martinberlin/H-spi-adapters/1.54-watch-pcb/154-watch.kicad_pcb

## KiCad design 1.54-watch-pcb/154-watch.kicad_pcb (2023-06-03)

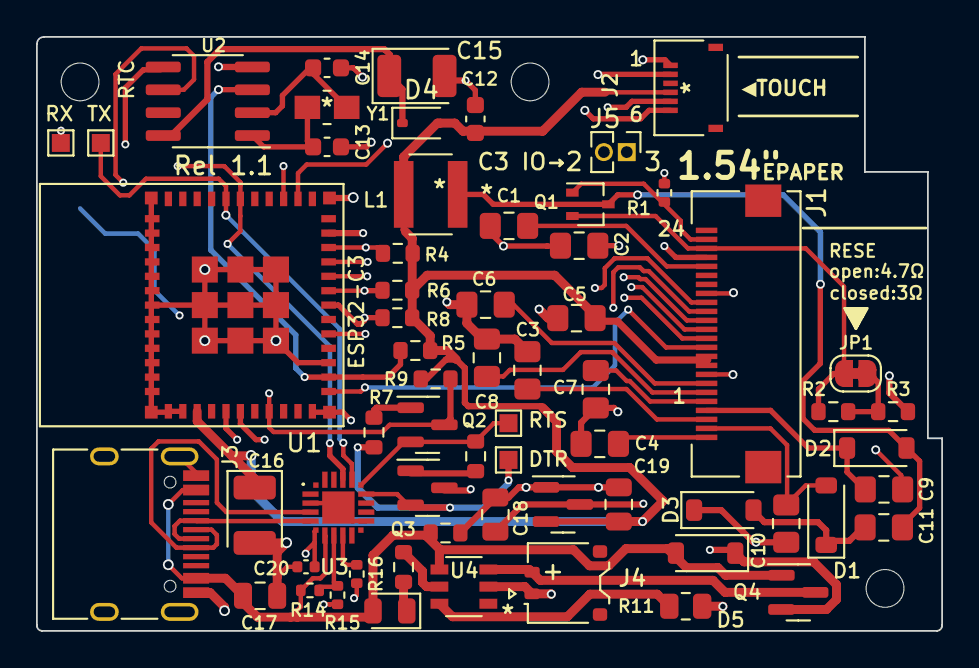
[picture p3: board 154-watch.kicad_pcb from above]

Board: 4 copper layers, 50.3 x 33.0 mm, 67 parts (1 on the bottom side), 51 nets.

Parts:
C1, C2, C3, C7, C9, C10: 4.7uF; C_0805_2012Metric_Pad1.18x1.45mm_HandSolder
C4, C5, C6, C8: 1uF; C_0805_2012Metric_Pad1.18x1.45mm_HandSolder
C11: 4.7uF 50V; C_0805_2012Metric_Pad1.18x1.45mm_HandSolder
C12: 4.7uF; C_0603_1608Metric
C13, C14: 12 pF; C_0603_1608Metric
C15, C16: C_Polarized 100uF; CP_EIA-3528-21_Kemet-B
C17: 100 nF; C_0805_2012Metric
C18, C19: 10uF; C_0805_2012Metric
C20: 1uF; C_0402_1005Metric
D1, D2, D3: MBR0530; D_SOD-123
D4: 1N4148WS; D_SOD-323
D5: 1N5817; D_SOD-123
D6: GRE; LED_0805_2012Metric
H1, H3, H4: MountingHole; MountingHole_2.1mm
J1: AFC24-S24FIC-00
J2: Conn_01x06_Female; FH34SRJ-6S-0.5SH50-Hirose
J3: USB_C_Programming; USB_C_Receptacle_HRO_TYPE-C-31-M-12
J4: Jack-DC; JST_ACH_BM02B-ACHSS-GAN-ETF_1x02-1MP_P1.20mm_Vertical
J5: Conn_01x02_Male; PinHeader_1x02_P1.27mm_Vertical
JP1: Jumper_2_Bridged; SolderJumper-2_P1.3mm_Bridged_RoundedPad1.0x1.5mm
L1: 10uH; SWPA4030S1R0NT
Q1: Si1308; SOT-323_SC-70
Q2, Q3: BC817; SOT-23
Q4: Si2301CDS; SOT-23
R1: 10K; R_0402_1005Metric
R2: 1.7R; R_0603_1608Metric
R3: 3R; R_0603_1608Metric
R4: 4.7 K; R_0603_1608Metric
R5, R7, R9, R10: 10 K; R_0603_1608Metric
R6, R8: 4.7K; R_0603_1608Metric
R11: 2K2; R_0805_2012Metric
R12: 5K; R_0603_1608Metric
R13: 10K; R_0603_1608Metric
R14: 22K; R_0402_1005Metric
R15: 47K; R_0402_1005Metric
R16: 4.7K; R_0402_1005Metric
SW1: RESET; Alps_SKRK
TP1, TP2, TP3, TP4: 32Khz; TestPoint_Pad_1.0x1.0mm
U1: ESP32-C3-MINI-1-N4
U2: PCF8563T; SOIC-8_3.9x4.9mm_P1.27mm
U3: CP2102N-Axx-xQFN20; CP2102NA02GQFN20
U4: TP4057-42-SOT26-R
U5: MCP1700-3302E_SOT23; SOT-23
Y1: Crystal_Small; Q13FC1350000400-Crystal

Connections:
+3V3: C5.2, C12.2, C16.1, C19.1, D4.2 (A), J1.9, J1.10, J2.4, L1.2, R4.1, R5.1, R6.2, R8.2, R9.1, U1.3 (3V3), U5.2 (VO)
/CTS: Q3.2 (E), R7.2, TP2.1, U3.15 (~CTS)
/EPD_BUSY: J1.16, U1.21 (IO7)
/EPD_CLK: J1.12, U1.20 (IO6)
/EPD_CS: J1.13, U1.27 (IO19)
/EPD_DC: J1.14, U1.26 (IO18)
/EPD_MOSI: J1.11, U1.12 (IO0)
/EPD_RST: J1.15, U1.16 (IO10)
/I2C_SCL: J2.5, R8.1, U1.18 (IO4), U2.6 (SCL)
/I2C_SDA: J2.6, R6.1, U1.19 (IO5), U2.5 (SDA)
/IO_2: J5.1, U1.5 (IO2)
/IO_3: J5.2, U1.6 (IO3)
/RTC_INT: R5.2, U1.13 (IO1), U2.3 (~INT)
/RTS: Q2.2 (E), R10.1, TP1.1, U3.16 (~RTS)
/TOUCH_INT: J2.2, R4.2, U1.22 (IO8)
/VCOM: C4.2, J1.1
BOOTMODE: Q3.3 (C), U1.23 (IO9)
GND: C1.1, C2.1, C3.1, C4.1, C5.1, C6.1, C7.1, C8.1, C9.1, C10.1, C12.1, C13.1, C14.1, C15.2, C16.2, C17.2, C18.2, C19.2, C20.2, D3.1 (K), J1.8, J1.17, J2.1, J3.A1 (GND), J3.A12 (GND), J3.B1 (GND), J3.B12 (GND), J3.S1 (SHIELD), J4.1, R1.2, R3.2, R11.1, R13.1, R15.2, SW1.2, U1.1 (GND), U1.2 (GND), U1.11 (GND), U1.14 (GND), U1.36 (GND), U1.37 (GND), U1.38 (GND), U1.39 (GND), U1.40 (GND), U1.41 (GND), U1.42 (GND), U1.43 (GND), U1.44 (GND), U1.45 (GND), U1.46 (GND), U1.47 (GND), U1.48 (GND), U1.49 (GND), U1.50 (GND), U1.51 (GND), U1.52 (GND), U1.53 (GND), U1.54 (GND), U1.55 (GND), U1.56 (GND), U1.57 (GND), U1.58 (GND), U1.59 (GND), U1.60 (GND), U1.61 (GND), U2.4 (VSS), U4.2 (GND), U5.1 (GND)
unnamed: C15.1, D4.1 (K), U2.8 (VDD)
unnamed: C1.2, J1.20
unnamed: C2.2, J1.21
unnamed: C3.2, J1.3
unnamed: C6.2, J1.7
unnamed: C7.2, J1.5
unnamed: C8.2, J1.6
unnamed: C10.2, D1.2 (A), J1.2
unnamed: C11.1, D1.1 (K), D3.2 (A)
unnamed: C11.2, D2.2 (A), L1.1, Q1.3 (D)
unnamed: C18.1, D5.1 (K), Q4.2 (S), U5.3 (VI)
unnamed: D6.1 (K), R12.2
unnamed: J1.22, JP1.1 (A), Q1.2 (S), R2.1
unnamed: JP1.2 (B), R2.2, R3.1
unnamed: J1.23, Q1.1 (G), R1.1
unnamed: Q2.1 (B), R7.1
unnamed: Q2.3 (C), R9.2, SW1.1, U1.8 (EN)
unnamed: Q3.1 (B), R10.2
unnamed: C13.2, U2.1 (OSCI), Y1.2
unnamed: C14.2, U2.2 (OSCO), Y1.1
unnamed: J3.A6 (D+), J3.B6 (D+), U3.4 (D+)
unnamed: J3.A7 (D-), J3.B7 (D-), U3.5 (D-)
unnamed: U3.3 (GND), U3.12 (GND), U3.21 (GND)
unnamed: R14.2, R15.1, U3.8 (VBUS)
unnamed: R16.2, U3.9 (~RST)
unnamed: R12.1, U4.5 (*STDBY)
unnamed: R11.2, U4.6 (PROG)
PREVGH: C9.2, D2.1 (K), J1.4
RX: TP4.1, U1.31 (TXD0), U3.17 (RXD)
TX: TP3.1, U1.30 (RXD0), U3.18 (TXD)
UART_VDD: C20.1, R16.1, U3.6 (VDD)
VBAT: J4.2, Q4.3 (D), U4.3 (BAT)
VBUS: C17.1, D5.2 (A), D6.2 (A), J3.A4 (VBUS), J3.A9 (VBUS), J3.B4 (VBUS), J3.B9 (VBUS), Q4.1 (G), R13.2, R14.1, U3.7 (VREGIN), U4.4 (VCC)
