martinberlin/H-spi-adapters/tinypico-uc8156/PLogic-SPI-HAT.kicad_pcb

## KiCad design tinypico-uc8156/PLogic-SPI-HAT.kicad_pcb (2022-03-20)

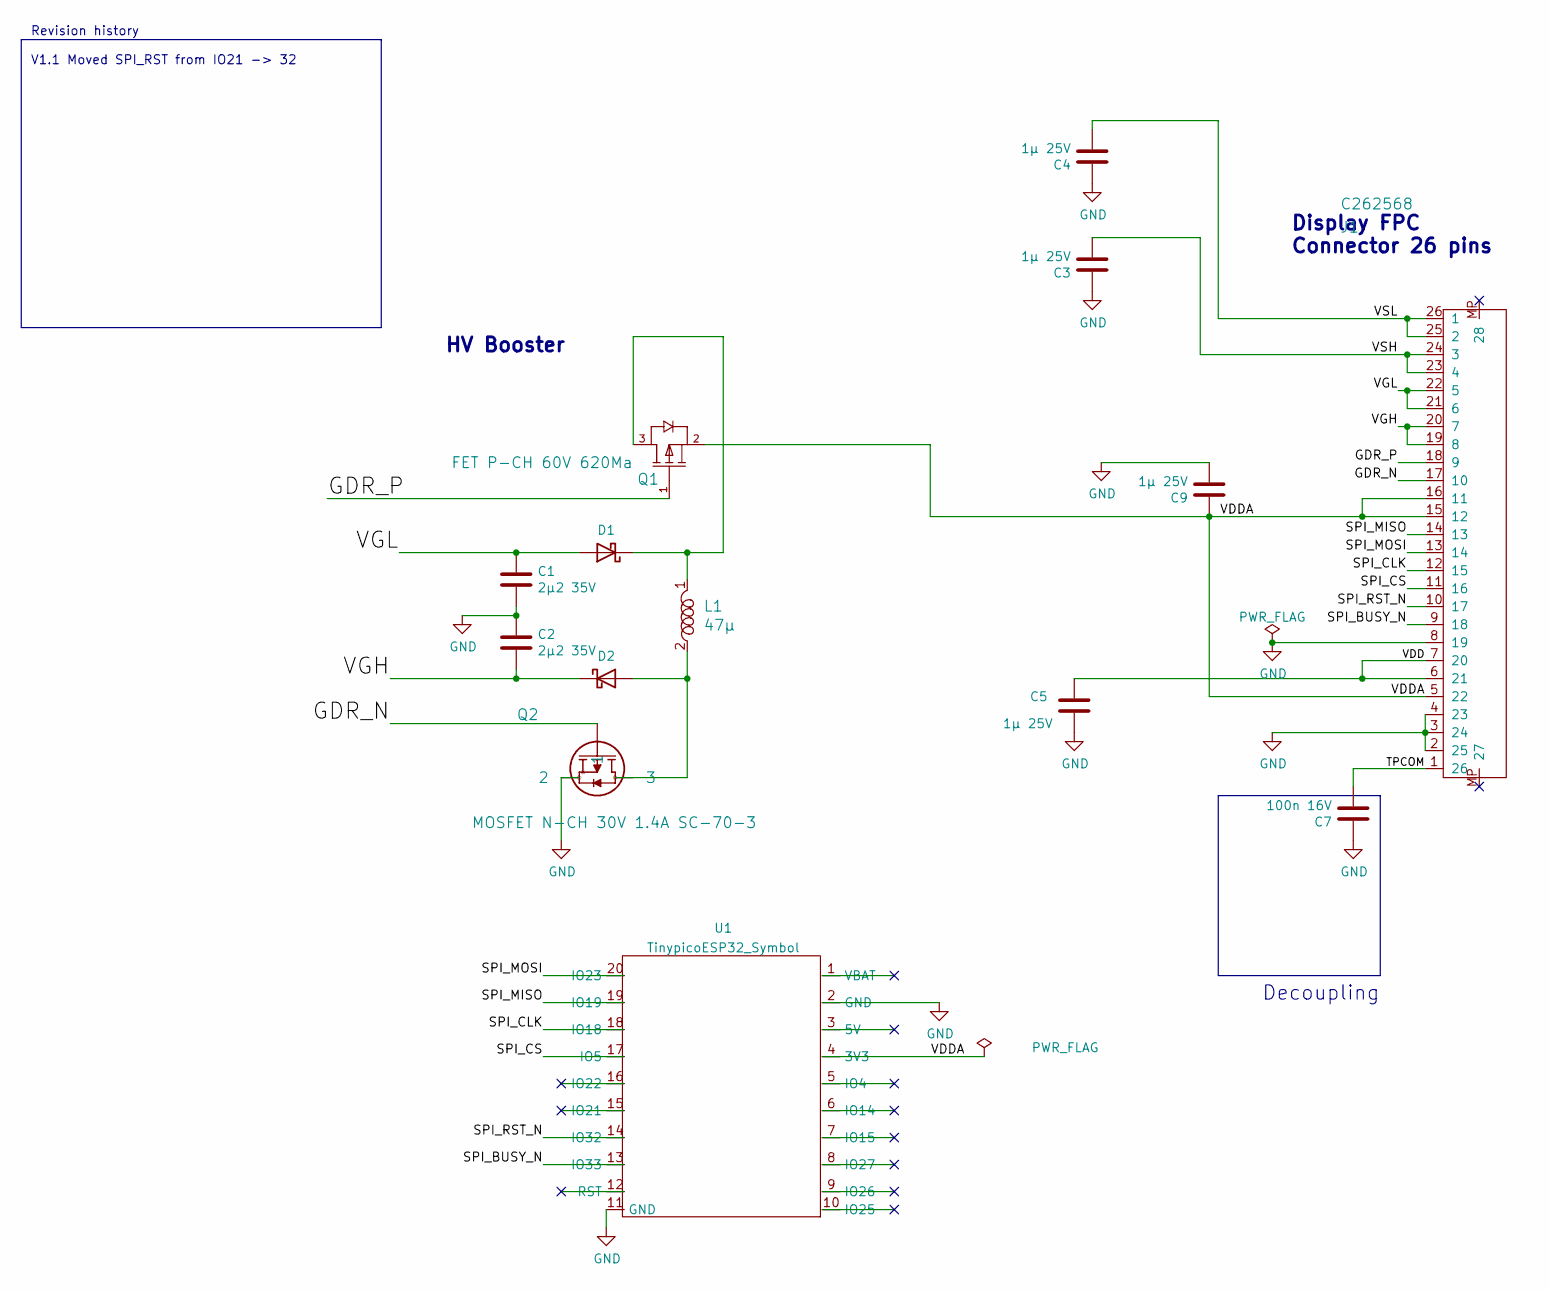
[picture p9: schematic PLogic-SPI-HAT.kicad_sch, PlasticLogic SPI HAT for tinyPico.com ESP32]

Parts:
C1, C2: 2µ2 35V; C_0603_1608Metric
C3, C4, C5, C9: 1µ 25V; C_0603_1608Metric
C7: 100n 16V; C_0603_1608Metric
D1, D2: D_Schottky; D_SOD-323; LCSC C154819
J1: C262568; TE_2-1734839-6_1x26-1MP_P0.5mm_Horizontal
L1: 47µ; 1210; MPN 82473C; Digi-Key_PN 811-2477-1-ND
Q1: FET P-CH 60V 620Ma; FET_BSR315PH6327XTSA1; MPN FQP27P06; Digi-Key_PN FQP27P06-ND
Q2: MOSFET N-CH 30V 1.4A SC-70-3; FET_SI1308EDL-SOT-323
U1: TinypicoESP32_Symbol; TinyESP32

Connections:
/GDR_N: J1.17 (10), Q2.1
/GDR_P: J1.18 (9), Q1.1 (GATE)
/SPI_BUSY_N: J1.9 (18), U1.13 (IO33)
/SPI_CLK: J1.12 (15), U1.18 (IO18)
/SPI_CS: J1.11 (16), U1.17 (IO5)
/SPI_MISO: J1.14 (13), U1.19 (IO19)
/SPI_MOSI: J1.13 (14), U1.20 (IO23)
/SPI_RST_N: J1.10 (17), U1.14 (IO32)
/TPCOM: C7.2, J1.1 (26)
/VDD: C5.1, J1.6 (21), J1.7 (20)
/VDDA: C9.1, J1.5 (22), J1.15 (12), J1.16 (11), Q1.2 (SOURCE), U1.4 (3V3)
/VGH: C2.2, D2.1 (K), J1.19 (8), J1.20 (7)
/VGL: C1.1, D1.2 (A), J1.21 (6), J1.22 (5)
/VSH: C3.2, J1.23 (4), J1.24 (3)
/VSL: C4.2, J1.25 (2), J1.26 (1)
GND: C1.2, C2.1, C3.1, C4.1, C5.2, C7.1, C9.2, J1.2 (25), J1.3 (24), J1.4 (23), J1.8 (19), Q2.2, U1.2 (GND), U1.11 (GND)
unnamed: D1.1 (K), L1.1, Q1.3 (DRAIN)
unnamed: D2.2 (A), L1.2, Q2.3

Notes on the sheet:
Revision history V1.1 Moved SPI_RST from IO21 -> 32
Decoupling
HV Booster
Display FPC Connector 26 pins

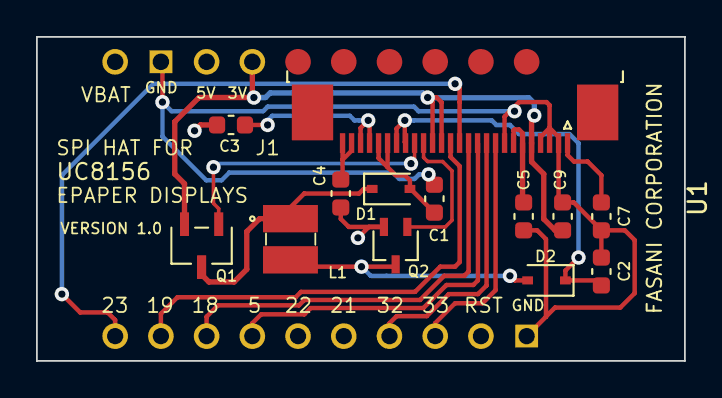
[picture p10: board PLogic-SPI-HAT.kicad_pcb from above]

Board: 2 copper layers, 36.0 x 18.0 mm, 14 parts (0 on the bottom side), 18 nets.
